Livesteamer2001/Loksteuerung_mini/README.md

# Loksteuerung_mini
Funkfernsteuerung für 5" und 7 1/4" Elektroloks, geeignet für 4QD-Leistungsteil
