Livesteamer2001/Loksteuerung_mini/Schaltpläne/BOM_Loksteuergeraet_2026-01-25.ods

ID | Name | Designator | Quantity |  | Preis
1 | 1u | C2 | 1
2 | Licht | CN1 | 1
3 | 1N4001 | D1 | 1
4 | 3V3 | D2 | 1
5 | FUSE HOLDER | F3 | 1 | https://amzn.eu/d/dxUeh0b | 0,55 €
6 | 3v3 | H1 | 1
7 | 5V | H2 | 1
8 | Hallsensor | J1 | 1
9 | Temperatur | J2 | 1
10 | Beleuchtung_F | J3,J4,J6 | 3 |  | 0,30 €
11 | Beleuchtung_R | J5 | 1 |  | 0,10 €
12 | I2C | J9 | 1
13 | SPI | J10 | 1
14 | 4QD | J11 | 1
15 | Horn | J12 | 1
16 | Stromv. Verstaerker | J13 | 1 | https://amzn.eu/d/9vcf2DT | 0,10 €
17 | XLC-6 | J14 | 1
18 | Motorklemmen | J15 | 1 |  | 0,10 €
19 | HK19F-DC5V-SHG(Y) | K1,K2,K3 | 3
20 | 1k8 | R1,R2,R6,R7,R8,R9 | 6
21 | 1k2 | R3 | 1
22 | 10k | R4,R10 | 2
23 | 1k | R5 | 1
24 | PB-05B-R | SW5 | 1
25 | BC547 | T1,T2 | 2 |  | 0,10 €
26 | ESP32-DEVKITC-VE | U2 | 1 | https://amzn.eu/d/c16QR4d | 10,00 €
27 | ULN2003AN | U3 | 1 | https://amzn.eu/d/7Dp9kp0 | 0,70 €
28 | LM2596 DC-DC | U6 | 1 | https://amzn.eu/d/9vcf2DT | 1,20 €
29 | Power 24V | U8 | 1 |  | 0,20 €
 | Kleinteile (Steckerleisten, Widerstände etc. |  |  |  | 5,00 €
 | Leiterplatte |  |  |  | 1,50 €
 |  |  |  |  | 19,85 €
