Livesteamer2001/Loksteuerung_mini/Schaltpläne/BOM_Sender_2025-12-27.ods

ID | Name | Designator | Quantity |  | Preis
1 | LiiPo-Akku 3000mAh | B1 | 1 | https://www.amazon.de/dp/B0F18ST3K5?ref_=ppx_hzod_title_dt_b_fed_asin_title_0_0&th=1 | 6,71 €
2 | Elko 10uF 16V | C1 | 1
3 | Potentiometer | H1 | 1 | https://www.amazon.de/dp/B0C9QGNDZ4?ref=ppx_yo2ov_dt_b_fed_asin_title&th=1 | 4,35 €
4 | Richtung 1-0-1 | H2 | 1 | https://www.amazon.de/dp/B0CYSYCWM9?ref=ppx_yo2ov_dt_b_fed_asin_title&th=1 | 0,30 €
5 | Licht 1-0-1 | H3 | 1 | https://www.amazon.de/dp/B0CYSYCWM9?ref=ppx_yo2ov_dt_b_fed_asin_title&th=1 | 0,30 €
6 | Horn | H4 | 1 | https://www.amazon.de/Gebildet-Momentan-Druckknopfschalter-Flachknopf-Wippschalter-Modelleisenbahn-Hobby/dp/B07XRKN3F3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 | 0,40 €
7 | Display (I2C) | H5 | 1 | https://www.amazon.de/GERUI-91-Zoll-OLED-LCD-Mikrocontrollern/dp/B0CT2QP43S | 2,70 €
8 | HDR-F-2.54_2x3 | H6 | 1
9 | LED | H7 | 1
10 | HDR-F-2.54_1x2 | H8,H9 | 2
11 | Batterie RAW | J1 | 1
12 | HDR-M-2.54_1x1 | J2,J3,J4,J5 | 4
13 | HDR-M-2.54_1x2 | J6,J7 | 2
14 | 1k8 | R1,R2 | 2
15 | 150k | R3 | 1
16 | 300R | R4 | 1
17 | Einschalter | SW1 | 1 | https://www.amazon.de/dp/B0FS1F5N5P?ref=ppx_yo2ov_dt_b_fed_asin_title | 0,70 €
18 | WEMOS_D1_MINI_PRO4 | U1 | 1 | https://www.amazon.de/dp/B0D66LXTTK?ref=ppx_yo2ov_dt_b_fed_asin_title&th=1 | 2,75 €
19 | USB-C Buchse |  | 1 | https://www.amazon.de/dp/B0CL9F34GT?ref=ppx_yo2ov_dt_b_fed_asin_title | 0,70 €
20 | Battery Shield für WEMOS |  | 1 | https://www.amazon.de/dp/B07XG817P8?ref=ppx_yo2ov_dt_b_fed_asin_title&th=1 | 2,20 €
21 | Leiterplatte |  |  |  | 1,00 €
22 | Kleinteile (Stecker, Widerstände) |  |  |  | 2,00 €
 |  |  |  |  | 24,11 €
