Livesteamer2001/Loksteuerung_mini/Bedienungsanleitungen/Bedienungsanleitung_groß.pdf

## Kurzanleitung für Funkfernsteuerung

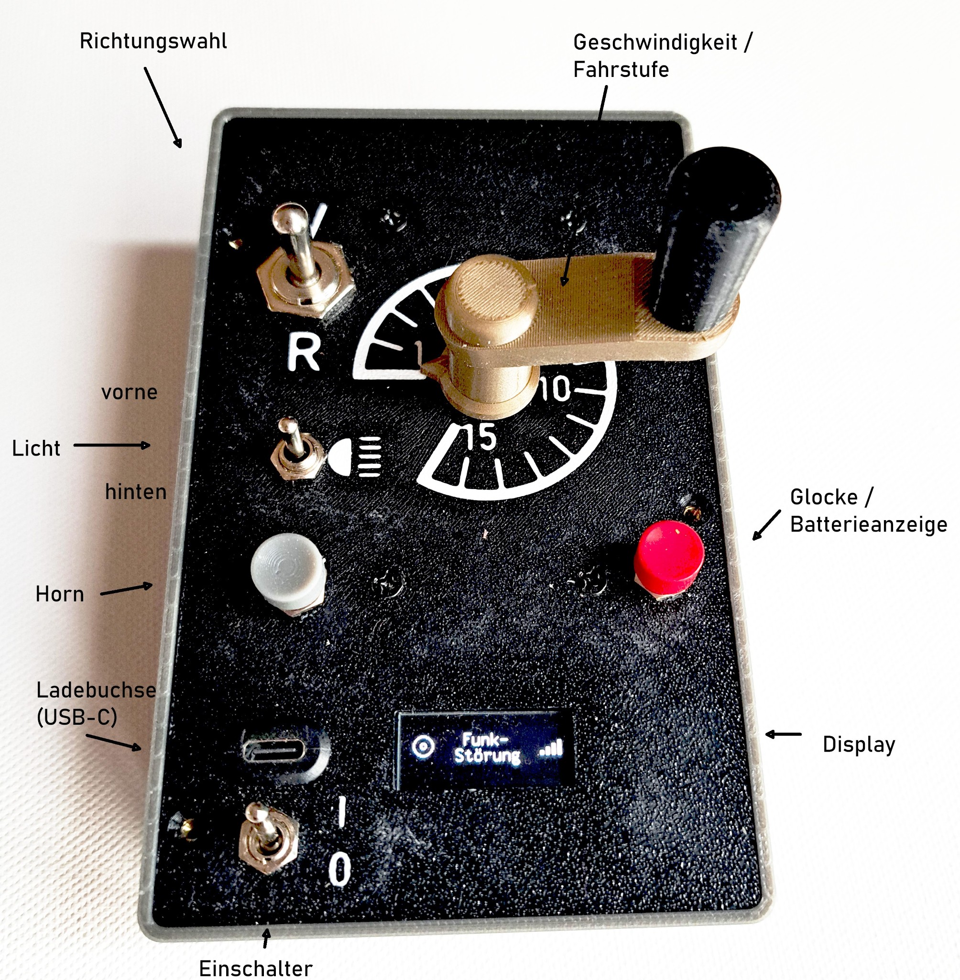
[picture p1: figure]

Einschalten: Taste „Horn“ drücken und halten, dann Einschalter auf „I“, bei Erfolg zeigt das

Display kurz an | , um dann die Grundstellung anzuzeigen:

Fahren: Fahrtrichtung mit Richtungswähler festlegen, Anzeige Display:

Nullstellungszwang: Wenn das Poti vor oder bei der Richtungswahl nicht auf Null steht, kommt die Fehlermeldung:

Funkstörung: Wenn das Loksteuergerät nicht gefunden wird oder im Betrieb außerhalb der Funkreichweite gerät, wird im Display „Funkstörung“ angezeigt. Die Balken auf der rechten Seite zeigen wie beim Mobiltelefon die Empfangsfeldstärke an.

Glocke / Batterieanzeige: kurzer Tastendruck auf die rote Taste aktiviert die
Glocke (falls vorhanden), längerer Tastendruck zeigt im Display den
Ladezustand des Senderakkus an:

Horn: Tastendruck auf die graue Taste aktiviert das Horn / Pfeife der Lok.

Licht: - Frontlicht (weiss) mit entsprechendem Schalter ein
- Frontlicht und Rücklicht (rot) auf entgegengesetzter Seite ein: Schalter kurz EIN – AUS – EIN (dauernd).

Senderakku laden: Ladebuchse (USB-C) mit Netzteil verbinden, vorher Sender einschalten (sonst wird nicht geladen!). Der aktuelle Ladezustand kann durch Druck auf die rote Taste angezeigt werden.

Sender neu zuordnen (Pairing):
Sender und Loksteuergerät sind über ihre MAC-Adressen fest miteinander verbunden (Pairing). Sollte der (seltene) Fall eintreten, dass der Sender mit einem anderen Lokempfänger gepaart werden muss, ist folgendermaßen vorzugehen:
- Pairing im Loksteuergerät löschen. Dazu den entprechenden Jumper in die andere Position stecken, das Loksteuergerät kurz einschalten, ausschalten und den Jumper wieder in ursprüngliche Position zurückstecken.
- Sender in den Pairingmodus bringen: Sender wie gewohnt einschalten,
wenn die Anzeige „System Starten…“ kommt, die rote Taste zusätzlich
drücken und beide Tasten 10 Sekunden halten:
- Wenn im Display „PAIRING…“ angezeigt wird, Loksteuergerät einschalten, im Display erscheint nun „Suche Lok…“. Jetzt sollten sich die beiden Geräte finden. Zum Schluss wird das Loksteuergerät automatisch neu gestartet.
