Livesteamer2001/Loksteuerung_mini/Schaltpläne/Schaltplan_Loksteuergerät_Dietz_V2.pdf

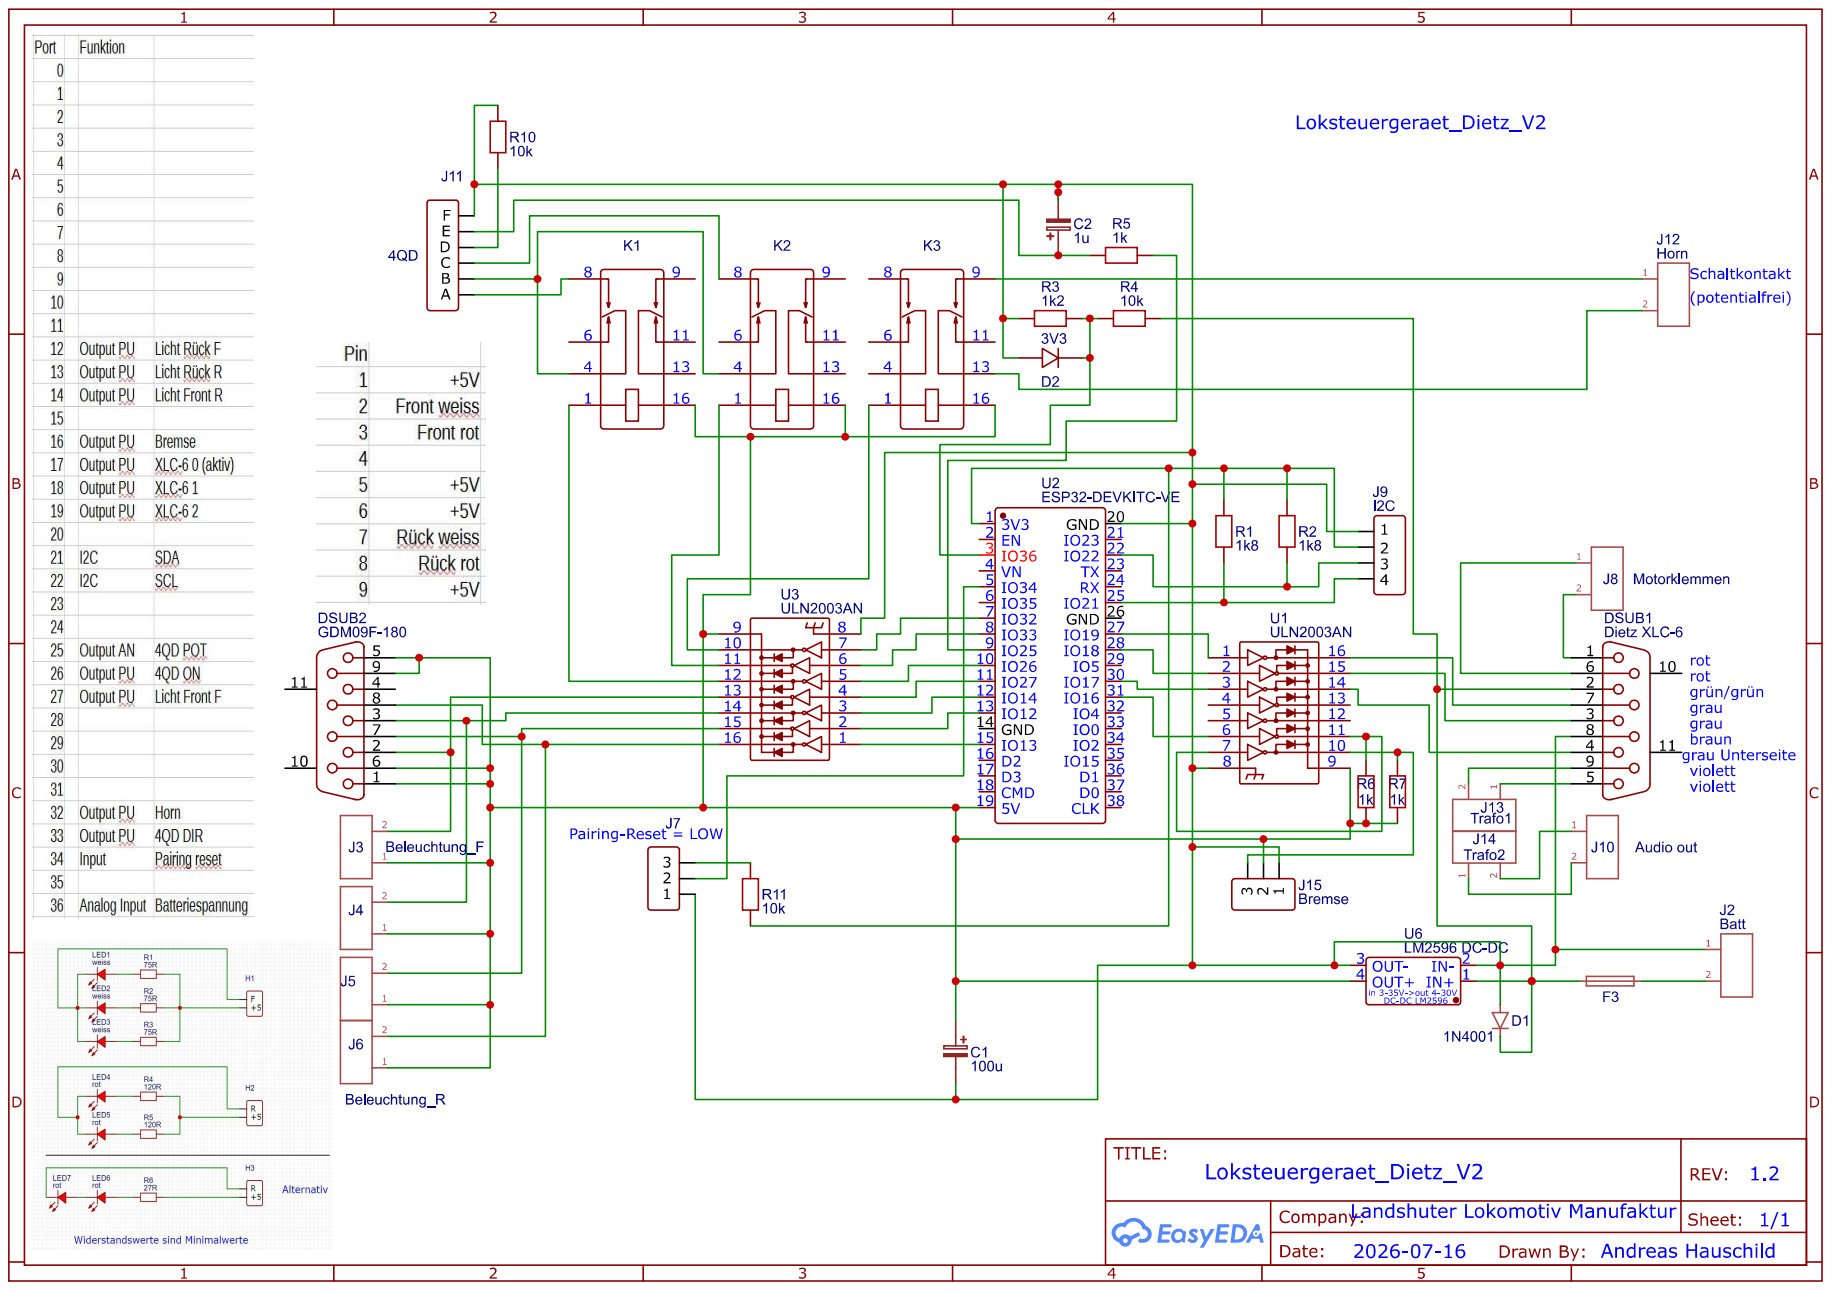
[picture p2: page 1]
