Livesteamer2001/Loksteuerung_mini/Schaltpläne/Schaltplan_Sender_Bremse_ESP32.pdf

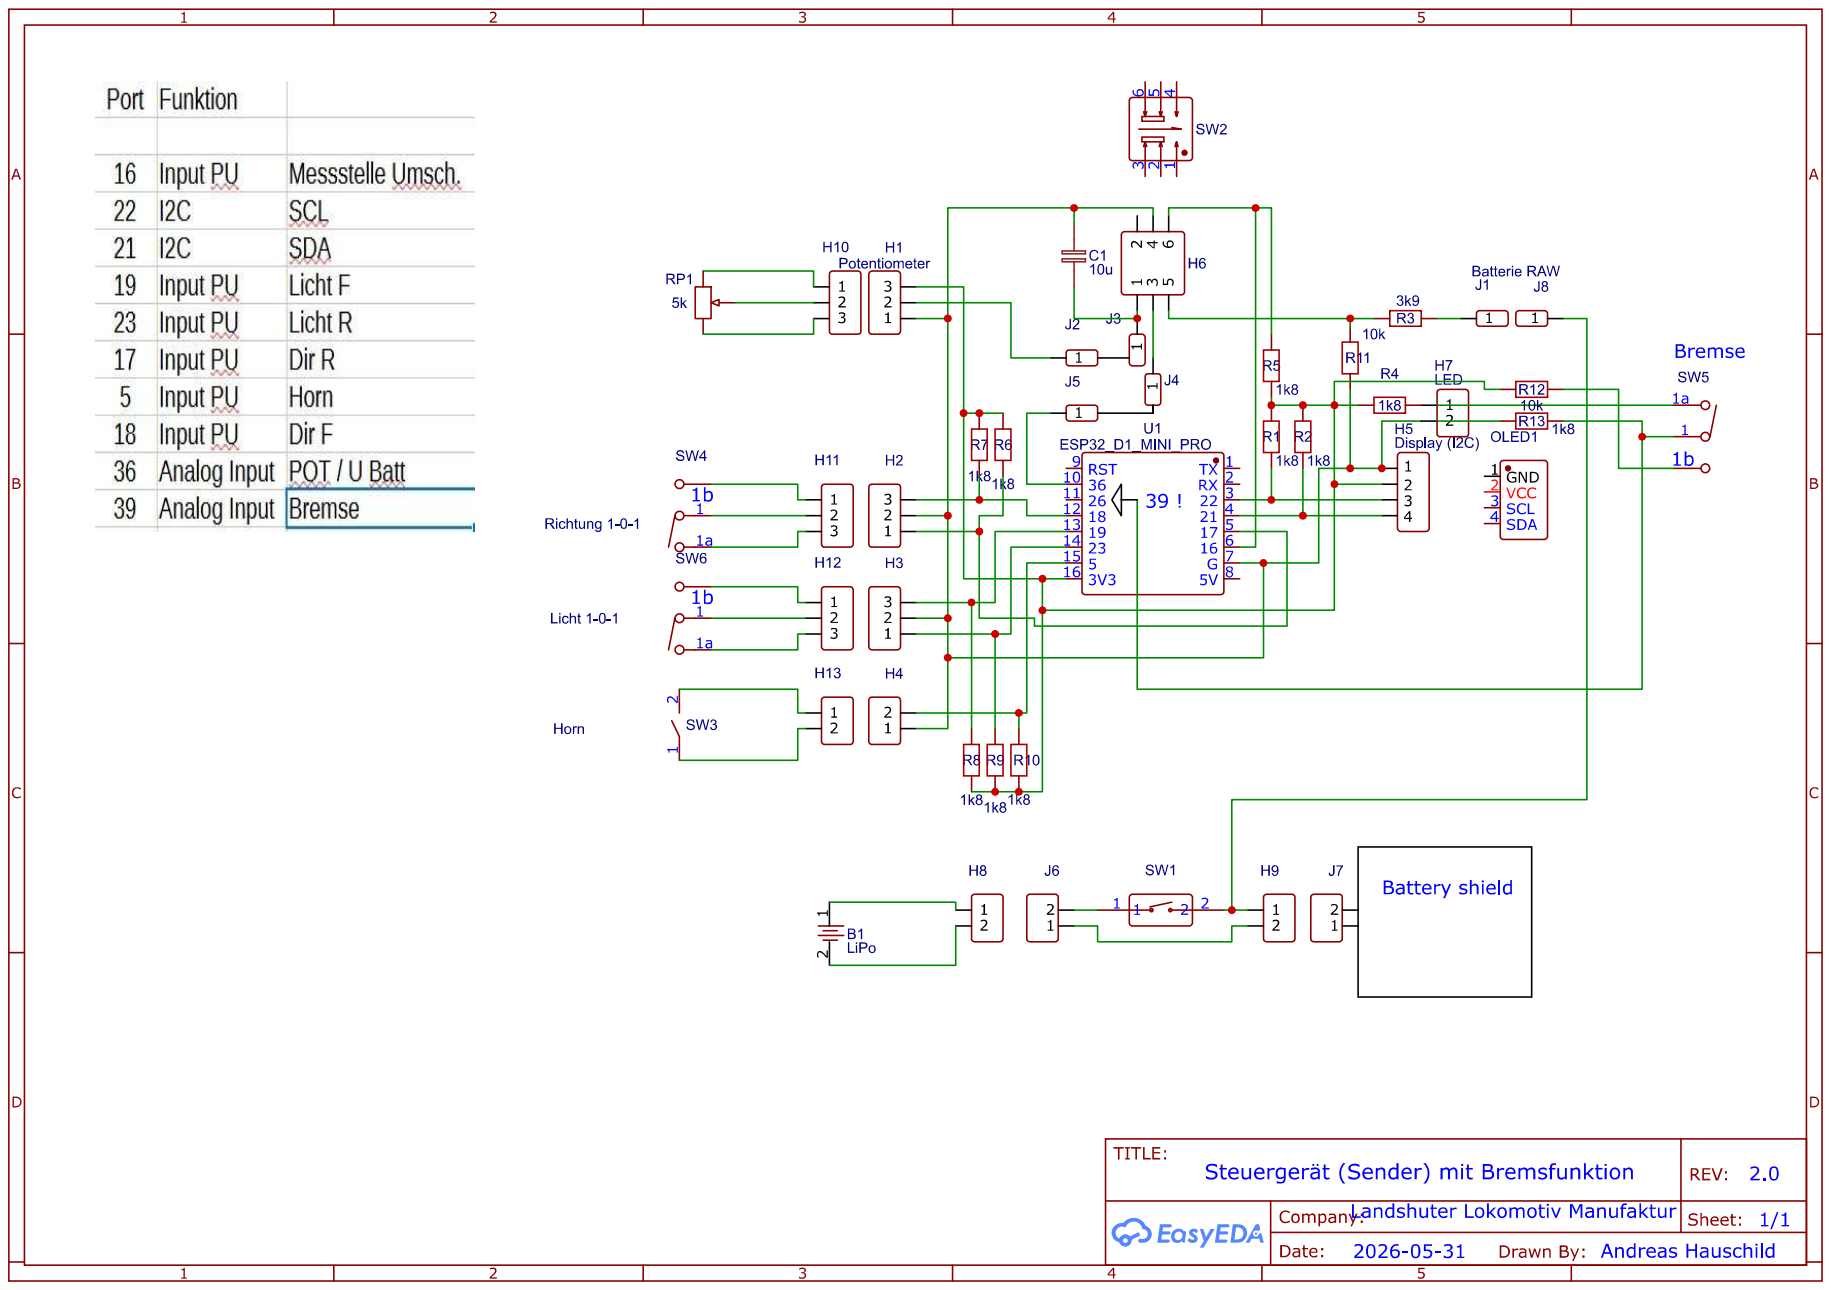
[picture p3: page 1]
