Livesteamer2001/Loksteuerung_mini/Schaltpläne/Schaltplan_Loksteuergerät.pdf

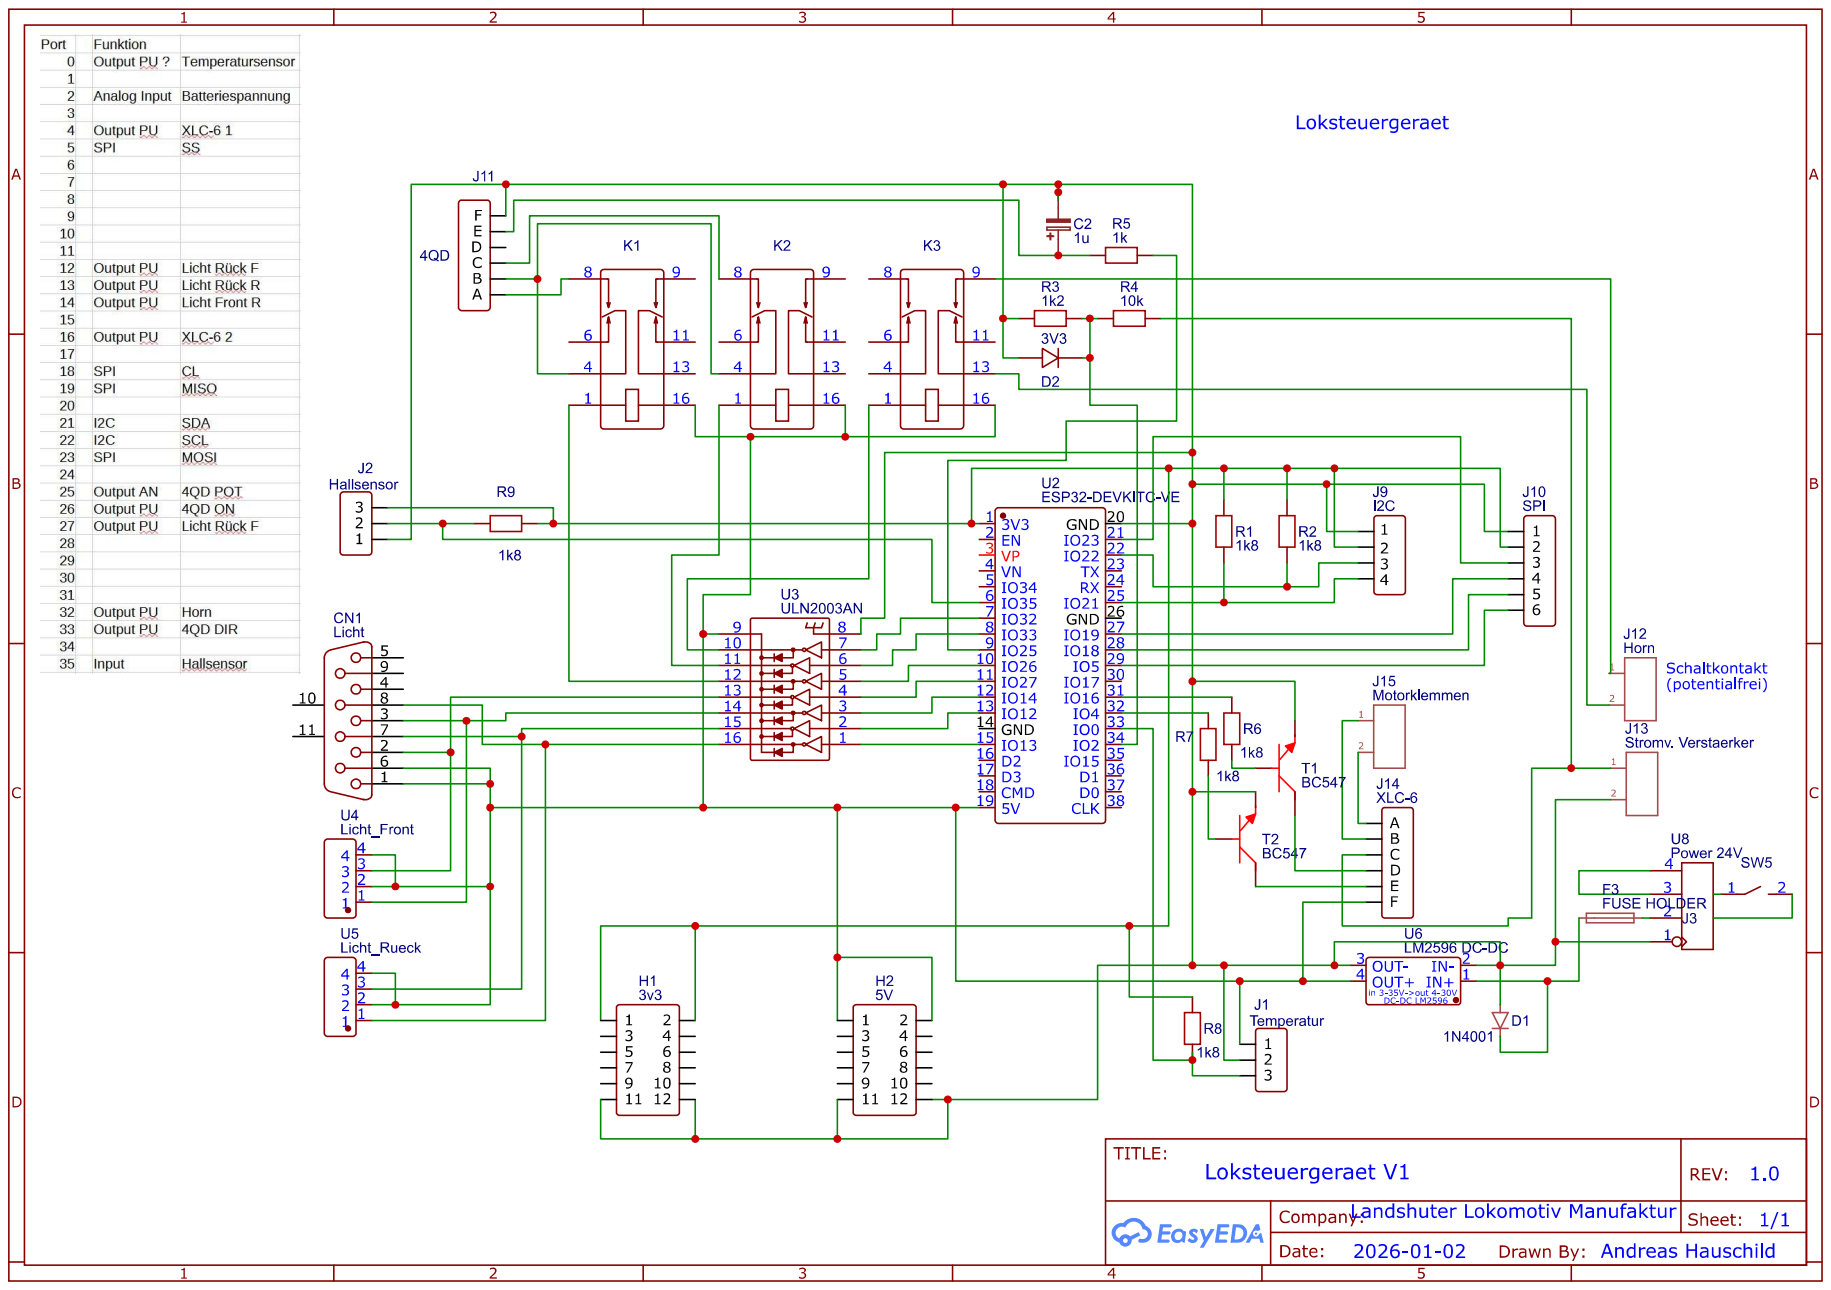
[picture p4: page 1]
