Livesteamer2001/Loksteuerung_mini/Schaltpläne/Schaltplan_Sender_mini.pdf

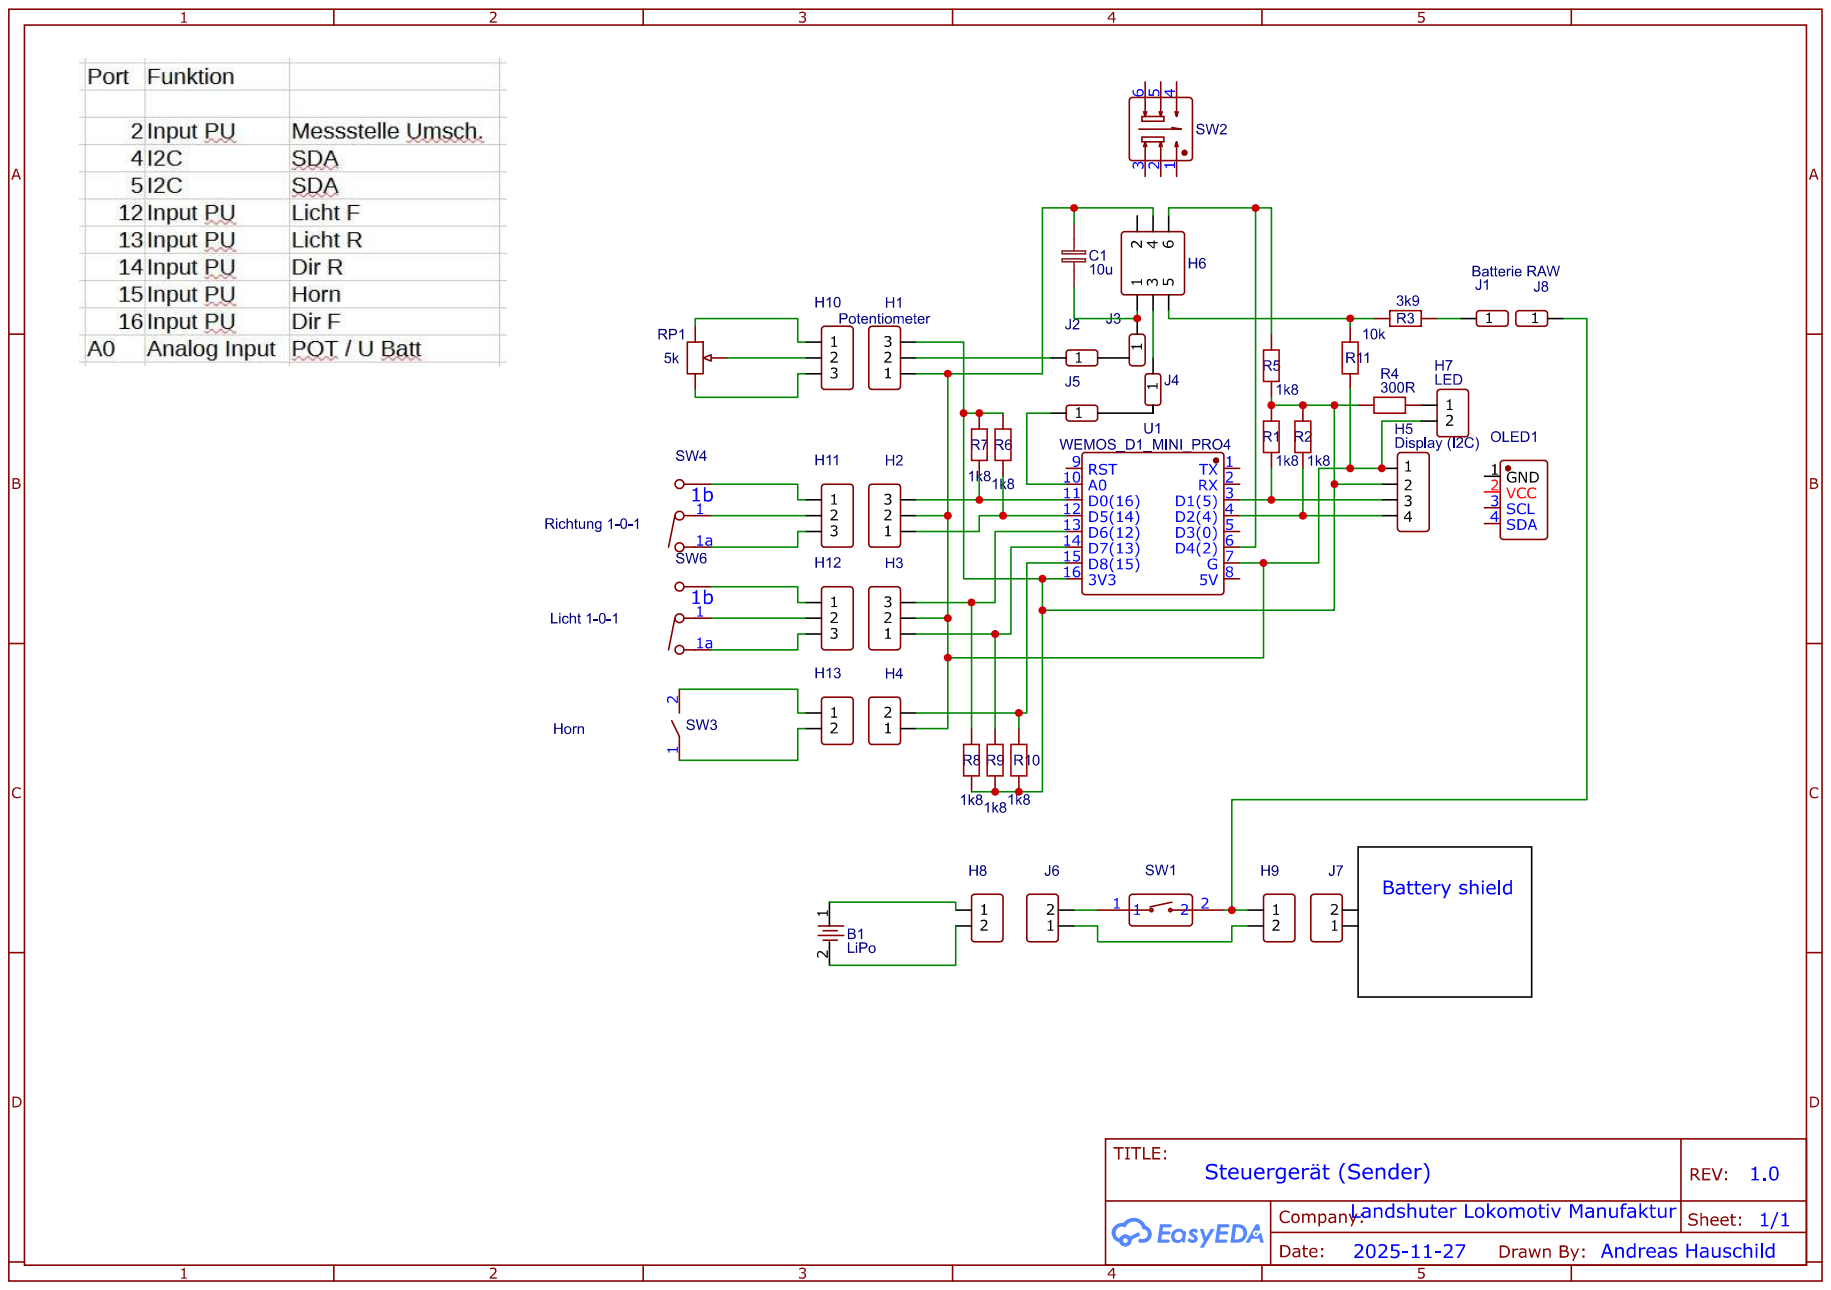
[picture p5: page 1]
