Livesteamer2001/Loksteuerung_mini/(commit log)

2026-01-25 Add files via upload
    Variante mit sub zum Anzeigen von Werten via Serial.print
2026-01-25 Add files via upload
    Variante mit Ausgabe über Serial.print
2026-01-25 Add files via upload
    Version 0.9 RC1, mit Temperatursensor
2026-02-17 Add files via upload
    Auto-pairing, wird aktiv, wenn die Horn-taste nach dem Einschalten > 10 sek gedrückt wird, danach dann Lok einschalten
2026-02-17 Add files via upload
    Zum Pairing muss Horn und UBatt gedrückt werden (siehe Prog)
2026-02-17 Add files via upload
    Mit Reset für MAC-Adresse
    [Loksteuergeraet_autopair.ino]
2026-06-09 Using ESP32D1mini
    Version für zusätzliche Bremse mittels Servo
2026-06-09 Using ESP32D1mini
    Variante mit Bremse
